PanosKons/VNA/docs/images/plots/lmatch_final_smith.png

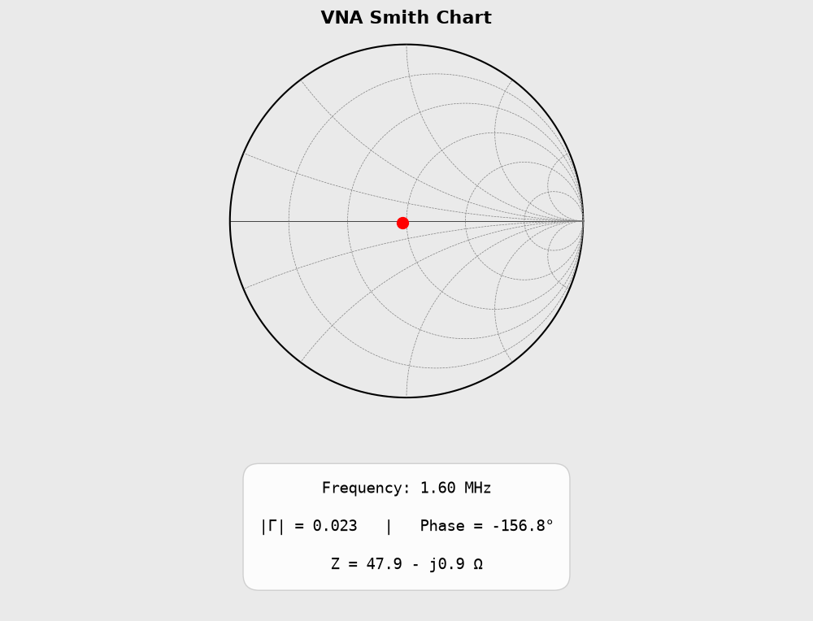
docs/images/plots/lmatch_final_smith.png
