PanosKons/VNA/docs/images/plots/transmission_line_single.png

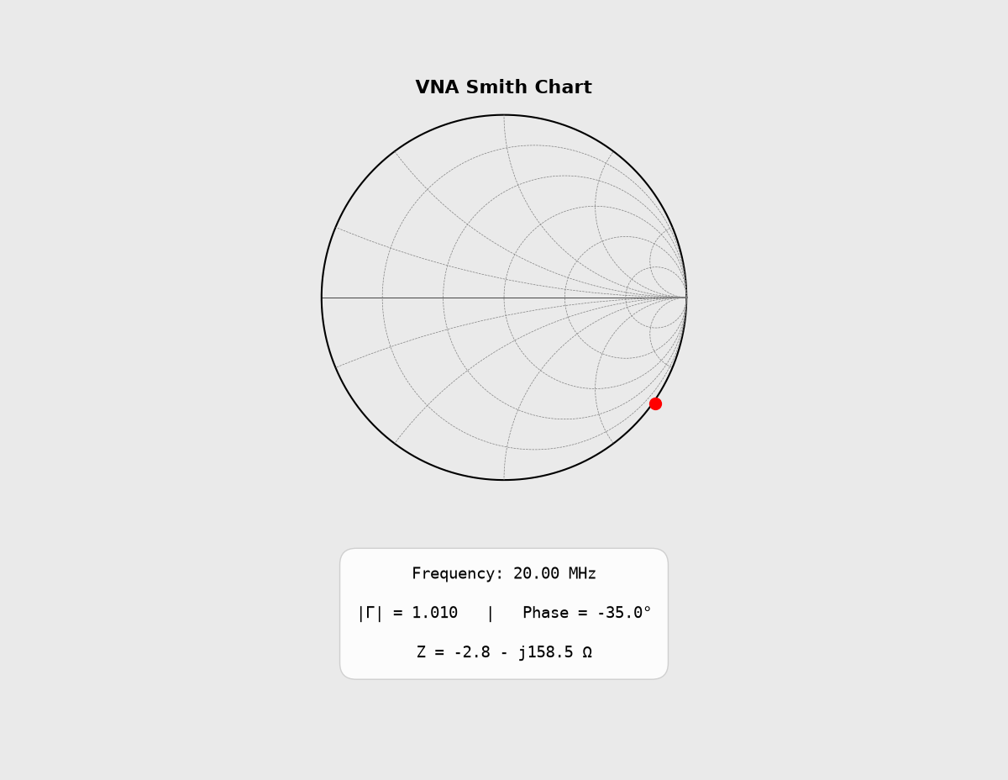
docs/images/plots/transmission_line_single.png
