PanosKons/VNA/Firmware/Core/Src/main.c

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
/* Includes ------------------------------------------------------------------*/
#include "main.h"

/* USER CODE BEGIN Includes */
#include <math.h>
#include <stdio.h>
/* USER CODE END Includes */


ADC_HandleTypeDef hadc1;
DMA_HandleTypeDef hdma_adc1;

TIM_HandleTypeDef htim2;

UART_HandleTypeDef huart2;

/* USER CODE BEGIN PV */
#define NUM_PAIRS 1000
#define TOTAL_SAMPLES (2*NUM_PAIRS)
volatile uint16_t adc_buffer[TOTAL_SAMPLES];
volatile uint8_t dma_complete = 0;
uint8_t rx_byte;

const float cos_ref[10] = {1.0f, 0.809017f, 0.309017f, -0.309017f, -0.809017f,
                          -1.0f, -0.809017f, -0.309017f, 0.309017f, 0.809017f};
const float sin_ref[10] = {0.0f, 0.587785f, 0.951057f, 0.951057f, 0.587785f,
                           0.0f, -0.587785f, -0.951057f, -0.951057f, -0.587785f};
/* USER CODE END PV */

void SystemClock_Config(void);
static void MX_GPIO_Init(void);
static void MX_DMA_Init(void);
static void MX_ADC1_Init(void);
static void MX_TIM2_Init(void);
static void MX_USART2_UART_Init(void);
/* USER CODE BEGIN 0 */

void HAL_ADC_ConvCpltCallback(ADC_HandleTypeDef* hadc) {
    if(hadc->Instance == ADC1) {
        dma_complete = 1;
    }
}
/* USER CODE END 0 */

/**
  * @brief  The application entry point.
  * @retval int
  */
int main(void)
{

  /* MCU Configuration--------------------------------------------------------*/

  /* Reset of all peripherals, Initializes the Flash interface and the Systick. */
  HAL_Init();

  /* Configure the system clock */
  SystemClock_Config();

  /* Initialize all configured peripherals */
  MX_GPIO_Init();
  MX_DMA_Init();
  MX_ADC1_Init();
  MX_TIM2_Init();
  MX_USART2_UART_Init();
  /* USER CODE BEGIN 2 */
  setvbuf(stdout, NULL, _IONBF, 0);
  HAL_ADCEx_Calibration_Start(&hadc1, ADC_SINGLE_ENDED);
  HAL_UART_Receive_IT(&huart2, &rx_byte, 1);

  /* USER CODE END 2 */

  /* Infinite loop */
  /* USER CODE BEGIN WHILE */
  while (1)
  {

    /* USER CODE END WHILE */

    /* USER CODE BEGIN 3 */
	  if (dma_complete) {
	      HAL_TIM_Base_Stop(&htim2);

	      float Ia = 0.0f, Qa = 0.0f;
	      float Ib = 0.0f, Qb = 0.0f;

	      int ref_idx = 0;

	      for (int i = 0; i < NUM_PAIRS; i++) {
	          float va_val = (float)adc_buffer[i * 2] - 2048.0f;
	          float vb_val = (float)adc_buffer[i * 2 + 1] - 2048.0f;

	          Ia += va_val * cos_ref[ref_idx];
	          Qa -= va_val * sin_ref[ref_idx];

	          Ib += vb_val * cos_ref[ref_idx];
	          Qb -= vb_val * sin_ref[ref_idx];

	          ref_idx++;
	          if (ref_idx >= 10) ref_idx = 0;
	      }

	      float scale = 2.0f / (float)NUM_PAIRS;
	      Ia *= scale; Qa *= scale;
	      Ib *= scale; Qb *= scale;


	      const float cos_delay = 0.99802f;
	      const float sin_delay = 0.06279f;
	      float Ib_corr = (Ib * cos_delay) + (Qb * sin_delay);
	      float Qb_corr = (Qb * cos_delay) - (Ib * sin_delay);

	      char tx_buffer[128];
	      int len = snprintf(tx_buffer, sizeof(tx_buffer),
	                         "Ia:%.2f Qa:%.2f Ib:%.2f Qb:%.2f\r\n",
	                         Ia, Qa, Ib_corr, Qb_corr);
	      HAL_UART_Transmit(&huart2, (uint8_t*)tx_buffer, len, HAL_MAX_DELAY);

	      dma_complete = 0;
	  }
}
  /* USER CODE END 3 */
}

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
/* USER CODE BEGIN 4 */
void HAL_UART_RxCpltCallback(UART_HandleTypeDef *huart) {
    if (huart->Instance == USART2) {
        if (rx_byte == 'M') {
            __HAL_ADC_CLEAR_FLAG(&hadc1, ADC_FLAG_OVR);
            HAL_ADC_Start_DMA(&hadc1, (uint32_t*)adc_buffer, TOTAL_SAMPLES);
            HAL_TIM_Base_Start(&htim2);
        }
        HAL_UART_Receive_IT(&huart2, &rx_byte, 1);
    }
}
/* USER CODE END 4 */
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
